abhijithvijayan/wireless-steering-wheel-controls/3d models/Receiver Case.FCStd

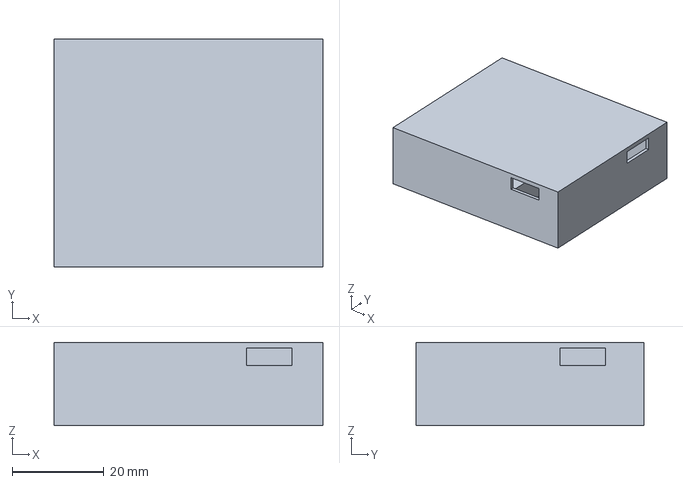
[picture p1: CAD file, 2026-10-20]
3d models/Receiver Case.FCStd
58.5 x 49.5 x 18.1 mm
