abhijithvijayan/wireless-steering-wheel-controls/circuit/custom/4051 v12.step

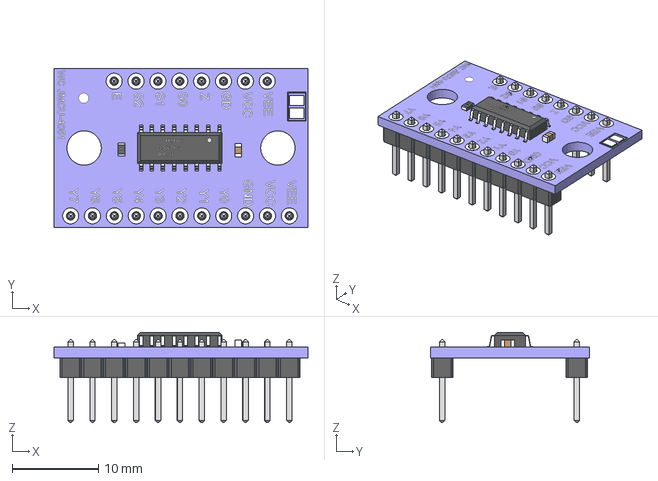
[picture p2: CAD file, 2026-10-20]
circuit/custom/4051 v12.step
29.5 x 18.5 x 10.5 mm
pinsocket v4
pinsocket v4 (1)
