abhijithvijayan/wireless-steering-wheel-controls/3d models/Receiver Case-Receiver Case.stl

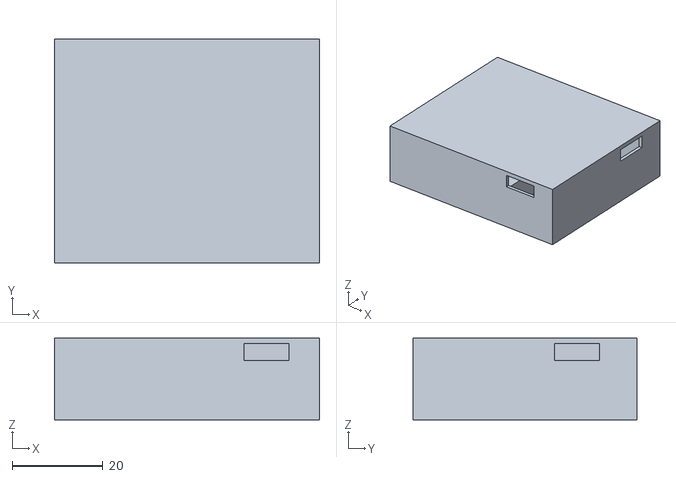
[picture p3: CAD file, 2026-10-20]
3d models/Receiver Case-Receiver Case.stl
58.5 x 49.5 x 18.1
