abhijithvijayan/wireless-steering-wheel-controls/3d models/Receiver Case Slicer File.3mf

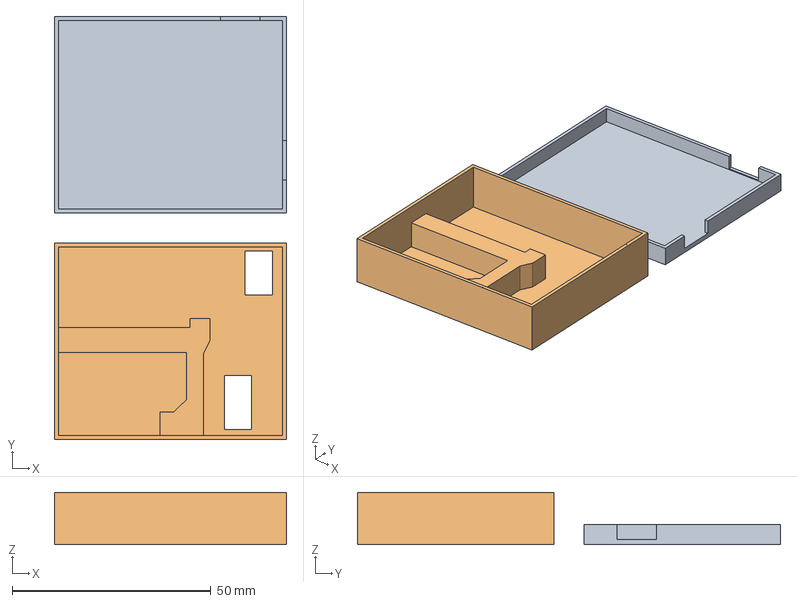
[picture p4: CAD file, 2026-10-20]
3d models/Receiver Case Slicer File.3mf
58.5 x 106.5 x 13.1 mm
Receiver Case-Receiver Case.stl x 2
