abhijithvijayan/wireless-steering-wheel-controls/circuit/receiver/receiver.kicad_pcb

## KiCad design circuit/receiver/receiver.kicad_pcb (2026-10-20)

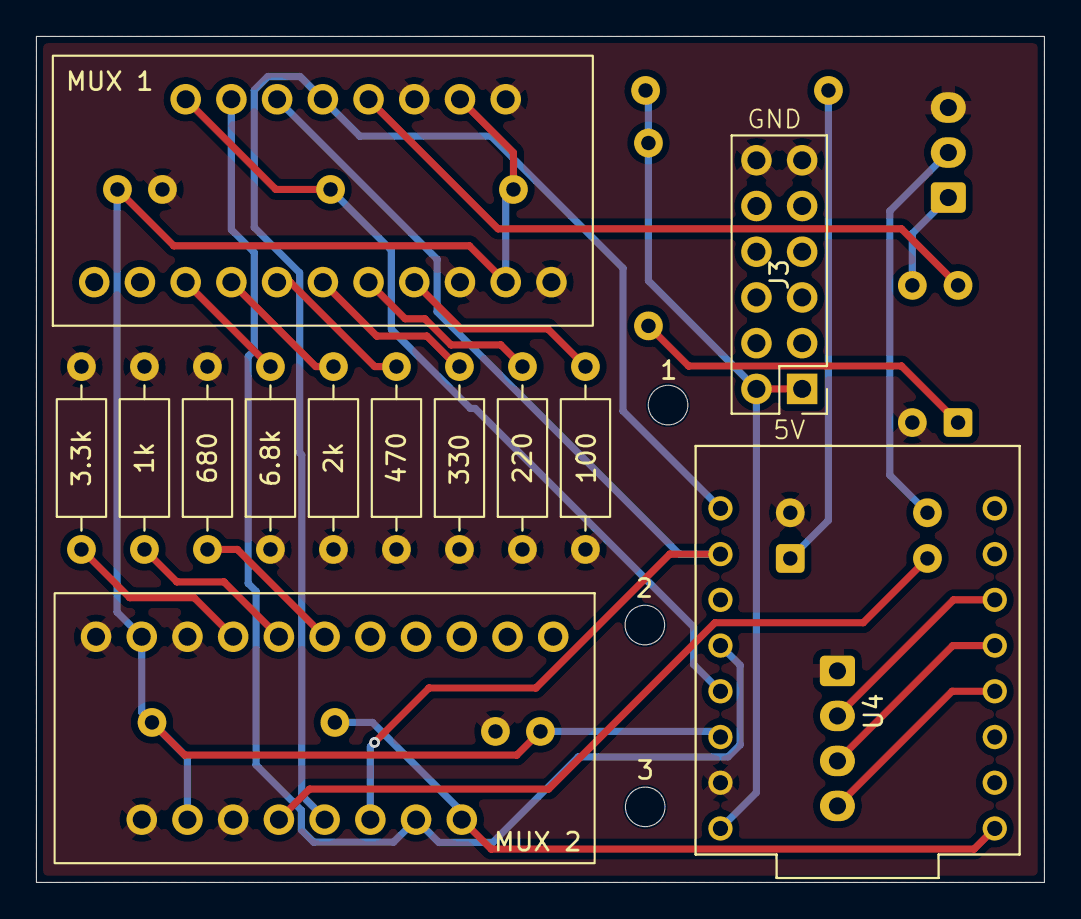
[picture p5: board receiver.kicad_pcb from above]

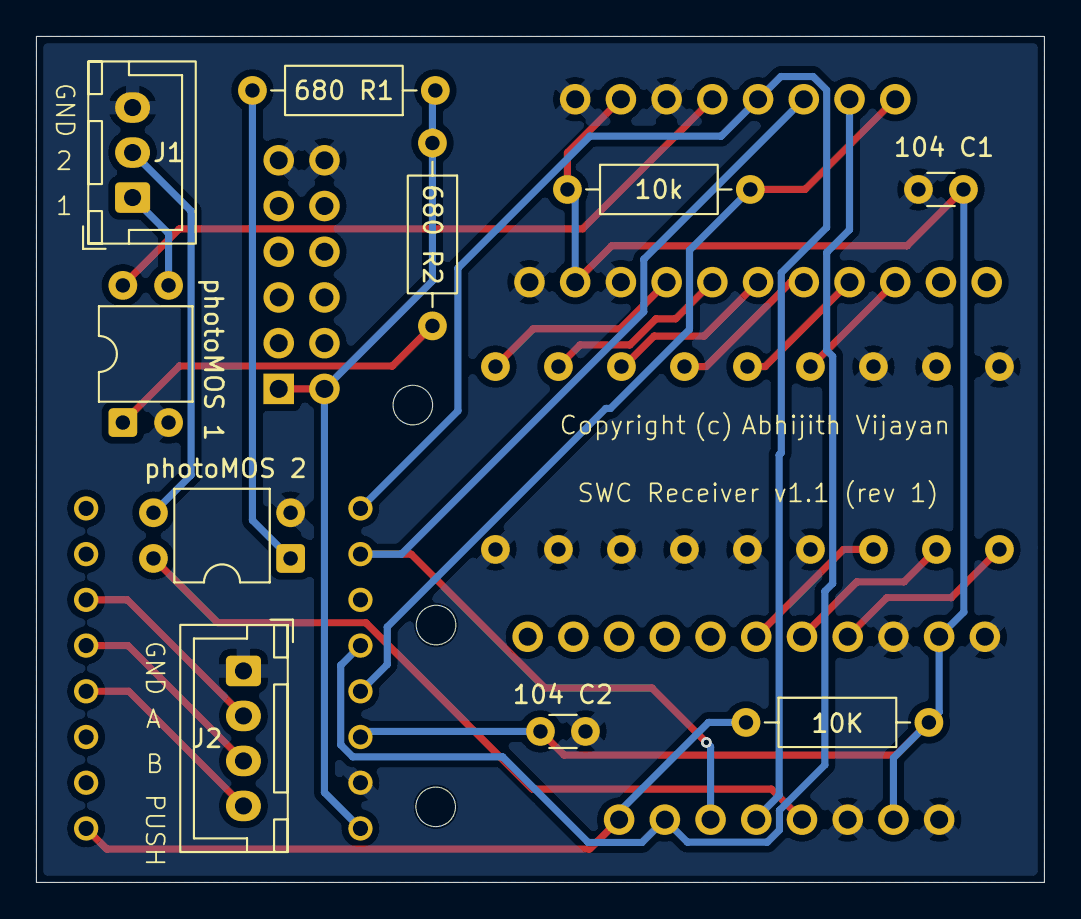
[picture p6: board receiver.kicad_pcb from below]

Board: 2 copper layers, 56.0 x 47.0 mm, 26 parts (10 on the bottom side), 26 nets.

Parts:
1, 2, 3: MountingHole_2.2mm_M2
1k: 1k; R_Axial_DIN0207_L6.3mm_D2.5mm_P10.16mm_Horizontal
2k: 2k; R_Axial_DIN0207_L6.3mm_D2.5mm_P10.16mm_Horizontal
3.3k: 3.3k; R_Axial_DIN0207_L6.3mm_D2.5mm_P10.16mm_Horizontal
6.8k: 6.8k; R_Axial_DIN0207_L6.3mm_D2.5mm_P10.16mm_Horizontal
10K, 10k: 10k; R_Axial_DIN0207_L6.3mm_D2.5mm_P10.16mm_Horizontal
100: 100; R_Axial_DIN0207_L6.3mm_D2.5mm_P10.16mm_Horizontal
104 C1, 104 C2: 100nF; C_Disc_D3.0mm_W1.6mm_P2.50mm
220: 220; R_Axial_DIN0207_L6.3mm_D2.5mm_P10.16mm_Horizontal
330: 330; R_Axial_DIN0207_L6.3mm_D2.5mm_P10.16mm_Horizontal
470: 470; R_Axial_DIN0207_L6.3mm_D2.5mm_P10.16mm_Horizontal
680, 680 R1, 680 R2: 680; R_Axial_DIN0207_L6.3mm_D2.5mm_P10.16mm_Horizontal
J1: Conn_01x03_Pin; JST_XH_B3B-XH-A_1x03_P2.50mm_Vertical
J2: Conn_01x04_Pin; JST_XH_B4B-XH-A_1x04_P2.50mm_Vertical
J3: Conn_02x06_Top_Bottom; PinHeader_2x06_P2.54mm_Vertical
MUX 1, MUX 2: 74HC4051; MUX_74HC4051_Module
U4: ESP32-C3_SUPERMINI_TH; MODULE_ESP32-C3_SUPERMINI_TH
photoMOS 1, photoMOS 2: AQY212EH; DIP-4_W7.62mm

Connections:
GND: 1k.2, 2k.1, 3.3k.2, 6.8k.1, 100.1, 104 C1.1, 104 C2.2, 220.1, 330.1, 470.1, 680.2, J1.3, J2.1, J3.11, J3.12, MUX 1.7 (VEE), MUX 1.8 (GND), MUX 2.7 (VEE), MUX 2.8 (GND), U4.G (GND), photoMOS 1.2, photoMOS 2.2
unnamed: J1.1, photoMOS 1.3
unnamed: J1.2, photoMOS 2.3
unnamed: J2.2, U4.10 (GPIO10)
unnamed: J2.3, U4.9 (GPIO9)
unnamed: J2.4, U4.8 (GPIO8)
unnamed: 680 R1.1, 680 R2.1, J3.1, J3.2, U4.5V
unnamed: 680 R2.2, photoMOS 1.1
unnamed: 680 R1.2, photoMOS 2.1
unnamed: 3.3k.1, MUX 2.13 (A0)
unnamed: 1k.1, MUX 2.14 (A1)
unnamed: 680.1, MUX 2.15 (A2)
unnamed: MUX 2.3 (A), photoMOS 2.4
unnamed: MUX 1.11 (S0), MUX 2.11 (S0), U4.0 (GPIO0)
unnamed: MUX 1.10 (S1), MUX 2.10 (S1), U4.1 (GPIO1)
unnamed: MUX 1.9 (S2), MUX 2.9 (S2), U4.3 (GPIO3)
unnamed: 10K.2, 10k.1, 104 C1.2, 104 C2.1, MUX 1.16 (VCC), MUX 2.16 (VCC), U4.3.3 (3V3)
unnamed: 10K.1, MUX 2.6 (~E), U4.5 (GPIO5)
unnamed: 100.2, MUX 1.13 (A0)
unnamed: 220.2, MUX 1.14 (A1)
unnamed: 330.2, MUX 1.15 (A2)
unnamed: 470.2, MUX 1.12 (A3)
unnamed: 2k.2, MUX 1.1 (A4)
unnamed: 6.8k.2, MUX 1.5 (A5)
unnamed: MUX 1.3 (A), photoMOS 1.4
unnamed: 10k.2, MUX 1.6 (~E), U4.4 (GPIO4)
