abhijithvijayan/wireless-steering-wheel-controls/(commit log)

2026-10-20 feat: 3d models
    [4051 v12.step, Receiver Case Slicer File.3mf, Receiver Case-Receiver Case.stl, Receiver Case.FCStd, receiver.kicad_pcb]
2026-10-20 feat: patch kicadStepUpMod
2026-10-20 refactor: use old improved flow to prevent stereo buzzing on every hold of volume / src
    [main.cpp]
