abhijithvijayan/wireless-steering-wheel-controls/(notices)

Notices in the files:
circuit/receiver/receiver.kicad_pcb:
Copyright (c) Abhijith Vijayan
